DoESLiverpool/circular_knitic/Arduino/VarispeedStepperCircuit_bb.png

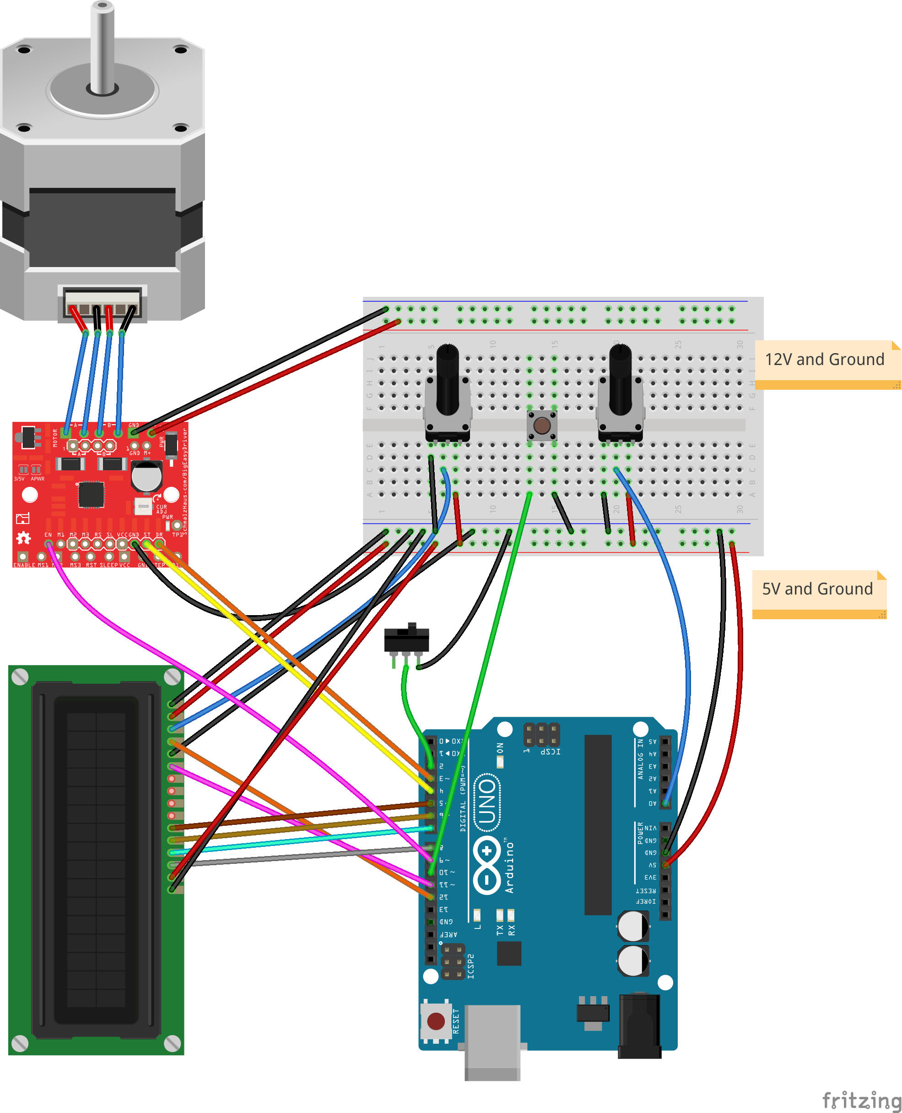
Arduino/VarispeedStepperCircuit_bb.png
