DoESLiverpool/circular_knitic/(list of files, drawings)

Other design files:
Arduino/VarispeedStepperCircuit.fzz
