DoESLiverpool/circular_knitic/(threads)

Thread 1 (2017-02-05):

Reassemble the contents of the electronics box

jackie1050, 2017-02-05:
Some of the electronics came apart when we disassembled the Knitic. There were also some wires that looks as though they had slightly overheated (we have always had issues with the fan). huffeec has taken the electronics box and contents home with the aim of getting a understanding of the best configuration, and getting it all working again.

huffeec, 2017-02-05:
Plan is to replace wires and get it back to working as it was, hopefully by or at the next maker night.
If anyone's got more time and wants to look at #3 at the same time I'd happily pass the bits over..

ajlennon, 2017-02-05:
I'd quite fancy trying to help out with #3 guys...

jackie1050, 2017-02-05:
That would be great – perhaps see how huffeec has got on by Thurs?
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

huffeec, 2017-02-06:
That'd be great @ajlennon
I'm not likely to be in the workshop before Thursday now but can drop off the bits before then if you want to have a look.

It's based on this at the moment,[https://github.com/DoESLiverpool/circular_knitic/blob/master/Arduino/CKcircuitSchema_pcb.jpg]( https://github.com/DoESLiverpool/circular_knitic/blob/master/Arduino/CKcircuitSchema_pcb.jpg) with an old PC PSU.

The motor is a [NEMA 23](http://www.active-robots.com/3330-0-57sth56-nema-23-bipolar-precision-gearless-stepper)

amcewen, 2017-02-17:
I've done some work on this, and completely rewritten the code for it.  The electronics are now next to the Knitic, and mostly wired up - it's missing the switch and the fan, but if you give it the 5V and 12V supplies then it'll run, and there's a new multi-turn potentiometer to allow finer-grained control.

The new code keeps track of how many steps it has triggered in `gStepCount` and prints out its RPM every five minutes to the serial port.  I think the calculated RPM might be double the RPM it's actually achieved, but haven't checked properly.  (Which is probably because the code thinks the Big Easy Driver is in 8-microstep mode, but it defaults to 16-microstep mode.  We can check that and update kStepsPerRevolution accordingly).

I've moved the circuit documentation to Fritzing.  It could do with the schematic tidying up (I've focused on the breadboard view so far) and the schematic and breadboard view exporting to images stored in the repo (to save anyone building one from installing Fritzing just to see how things are wired)

huffeec, 2017-03-11:
I've updated the code and circuit to include an LCD screen and controls for the row counter #3
This commit also has changes to the box of electronics svg to make space for the screen. The code is just 'Hello, Knitic' , and needs a line to convert between motor rotations and rows. (Anyone know what the gear ratio is?) dc1577902f17f0af19d053fcbce11e4b85cfec19

After maker day today I'm looking for a replacement 16x2 screen....

So, I've put the electronics box together without a screen and fixed the motor back. With progress on #5 the Knitic is now almost functional again. It needs the switch between pin2 and gnd, and the big easy board needs trimming.

huffeec, 2017-06-17:
The box was reassembled (without the screen) for Maker Faire.
It doesn't need any work, except if there is anything relating to #7 to be working for Make Fest.

paulgeering, 2017-06-18:
While swapping the PSU on Saturday (#7) I deactivated the arduino. (#13) This will be remedied Tomorrow.

paulgeering, 2017-06-19:
The electronics are now ready for Makefest Liverpool 2017. This will be the same setup as Newcastle (I.e. not using the screen and row counter)
#7 PSU tested and working
#13 Arduino replaced and tested.

Thread 2 (2017-02-05):

Replace the cracked upper surface of big gear

jackie1050, 2017-02-05:
The upper surface has been cracked since the Knitic was first assembled. 

jackie1050, 2017-02-05:
We cut another piece but it cracked when we tried to fit the 3D-printed "mountain" (cam). This appears to be due to the sharp corners and tight fit of the two pieces. We considered using MDF instead of acrylic, but decided this might be difficult to clean. We also considered rounding off the corners, but didn't do this as we had already printed off a new mountain using the existing file. It would be worth looking into this again if there are any future problems.

Kate bought a new piece of 5mm acrylic, and we cut a new upper surface using the existing .ai file (as we remembered there being scale problems with the svg). She filed down the mountain so that it fit better.

jackie1050, 2017-02-05:
Appears OK now

Closed 2017-02-05.

Thread 3 (2017-02-05):

Add a row counter

jackie1050, 2017-02-05:
Having a row counter would make it easier to replicate successful hats

huffeec, 2017-02-05:
The easiest way would be to count the rotations of the motor, but it does slip now and again. How accurate does it need to be?

Otherwise a little magnet on the big cog? I think there was a spare(?) Hall Effect sensor in the workshop, that might be enough. It'd also need a screen and possibly a button or two.

For persistence we would need a second switch to separate control of power and operation. This would also stop the lag we have at the moment waiting for the Arduino to power.

amcewen, 2017-02-17:
The new code (as mentioned in #1) tracks the number of steps made in a variable called `gStepCount`, so it would "just" need some sort of display adding to show that, and maybe a reset display to 0 button?

Thread 4 (2017-02-05):

Investigate replacement yarn tensioner

jackie1050, 2017-02-05:
We have had a lot of problems with this, and there is a new version on the main thread - Mar has recommended updating

Thread 5 (2017-02-05):

Reassemble Knitic

jackie1050, 2017-02-05:
On completion of #1

jackie1050, 2017-02-05:
... and make sure it's working well

huffeec, 2017-02-05:
This can happen independently of #1 the motor and box of electronics bolt onto the base.

It would be worth gluing the bottom and side pieces of the [box of electronics]( https://github.com/DoESLiverpool/circular_knitic/blob/master/2D_laser_cut/AI/box_of_electronics_5mm.ai ) together to make it easier to maintain.

A better solution to fix the power supply to the leg would be helpful too.

huffeec, 2017-02-24:
Made a lot of progress with @pounac on reassembling. Just needs the bearings refitting to the big cog, and the joining pieces on the 3d printed quadrants. Then everything could use checking for tightness.
I've glued the bottom of the electronics box together to make it easier to take apart in the future. For now just the switch and fan from #1 is enough to get this working again.

amcewen, 2017-06-10:
Given it has now been disassembled again, I'm going to use this to mark the reassembly for MakeFest.  This is dependent on issues #8 and #9 (at least).

huffeec, 2017-06-17:
The lower circle piece has been sanded to fit the bearing (from #8 which has been reassembled.)
and the inner ring and needles are in place.
Remaining are steps 11 - 14 in the [Circular Knitic instructable](https://www.instructables.com/id/Circular-Knitic/#step11)

Thread 6 (2017-02-05):

Reprint "mountain" cam, as wear could be causing problems

jackie1050, 2017-02-05:

jackie1050, 2017-02-05:
Once we disassembled the Knitic, we found that wear was less than we had been expecting. We took the opportunity to replace the mountain anyway.

Closed 2017-02-05.

Thread 7 (2017-03-11):

Replace PSU

huffeec, 2017-03-11:
We have a neater RS power supply that can replace the old computer unit.
It needs wiring and an enclosure that can be fixed under the box of electronics.
(Or the whole box of electronics redesigning?)

amcewen, 2017-06-10:
We've decided against the RS power supply now, haven't we?  Wasn't @paulgeering proposing switching to a beefy 12V wall-wart, so the barrel-jack plugs into the Arduino and we take the stepper feed from the Vin pin of the Arduino?

If so, how much current do we think the wall-wart needs to provide?

paulgeering, 2017-06-15:
Well, in the run up to Newcastle, I got a 12v 5A (60W) power supply for it and hooked it all up.
It was felt, by some experienced knitic users, that there was a noticeable drop in performance when using the new power supply, so we went back to using the PC power supply.

Shame the knitic is in pieces, otherwise we could run it and measure the current draw at 12v.

I guess we could put an artificial load on the stepper, and see what it maxes out at.
I'm around this evening, and happy to give that a go.

@amcewen do you have specs of the motor driver board max current draw, or is it the case that there is a recommended max, but the little board will try and keep up regarless of whether it is melting itself in the process?

amcewen, 2017-06-18:
@paulgeering It's a [Big Easy Driver board](http://www.schmalzhaus.com/BigEasyDriver/) which (according to that link) will handle around 2A per phase.  We could always try it on the bench power supply and look at how much current it draws in operation (with some wool in it), and then get something specced a healthy margin over that...

paulgeering, 2017-06-18:
On Saturday we measured the current draw at under 2 amps, we then did an A-B comparison between the PC power supply and the maplin one I mentioned.

They performed identically.

I've wired the knitic up so it will use the new power supply.

(The knitic is awaiting a replacement Arduino. I blew the current one up, as is my custom in the lead up to Maker fair/fest's.

There is a separate git hub issue for that, which will be resolved on Monday morning)

paulgeering, 2017-06-19:
New arduino in place. #13 Closed. All electronics working as expected.

Closed 2017-06-19.

Thread 10 (2017-06-10):

Fix eccentricity in stepper motor cog

amcewen, 2017-06-10:
The cog on the stepper motor wobbles quite a bit, which isn't helping how smoothly it runs.

amcewen, 2017-06-10:
A new cog (which will be cut as part of #9) might fix things.  Otherwise maybe it's because the mounting boss is for an imperial shaft and the shaft is metric. (Am I remembering that correctly @huffeec?)

huffeec, 2017-06-17:
Yes, the [motor](http://www.active-robots.com/3330-0-57sth56-nema-23-bipolar-precision-gearless-stepper) is 1/4" the [shaft mount](http://www.active-robots.com/pololu-universal-aluminum-mounting-hub-6mm-shaft-pair-m3-holes) is 6mm
I think it's more how the cog is mounted.
Rob replaced the cog to fix this.

Closed 2017-06-17.

Thread 11 (2017-06-10):

Upper surface keeps breaking

amcewen, 2017-06-10:
The laser-cut upper surface piece keeps snapping across the narrow part where the cut-out for the "mountain" part fits.

We suspect that it's caused by the stresses being focused in the sharp corner of the cut-out.  Rounding off that corner might fix things, which will need modifications to both the laser-cut part and the 3d-printed "mountain"

Kate2000, 2017-06-12:
[upper_surface_5mm_385mm.zip](https://github.com/DoESLiverpool/circular_knitic/files/1069012/upper_surface_5mm_385mm.zip)

I think this is the right sized version of the upper disk (385mm not 305mm) but it needs the circles on those corners.

Kate2000, 2017-06-12:
I've added in the circles (5mm) to save time.
Can you check if its ok? If not please can you re-do?

[upper_surface_5mm_385mm_mod.zip](https://github.com/DoESLiverpool/circular_knitic/files/1069056/upper_surface_5mm_385mm_mod.zip)

jackie1050, 2017-06-12:
Great – I’ll cut it tomorrow evening (13 June) then, unless anyone objects before then

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

huffeec, 2017-06-17:
The new circles are slightly out of round. It's especially a problem with the lower circle.
@paulgeering and @Kate2000 traced the problem with Gerald slightly distorting cuts 45 degrees to the axis.
We've sanded the current cut to fit the bearing and that should work for MakeFest. So the Knitic can be reassembled but longer term would benefit from new cuts.

jackie1050, 2017-06-19:
I bought a new piece of acrylic to make new circles once Gerald is fixed. I've written Knitic on the plastic covering, and stored it by the big pieces of polycarbonate for the moment

DefProc, 2017-06-21:
Gerald should now be ready for cutting rounds https://github.com/DoESLiverpool/somebody-should/issues/517

Thread 9 (2017-06-10):

Cut new 5mm acrylic pieces

amcewen, 2017-06-10:
We need an assortment of the 5mm acrylic parts cutting:

 * [x] [Cogs](https://github.com/DoESLiverpool/circular_knitic/blob/master/2D_laser_cut/SVG/bottom_surface_motor_gears_6mm.svg)
 * [x] [Upper surface](https://github.com/DoESLiverpool/circular_knitic/blob/master/2D_laser_cut/SVG/upper_surface_5mm.svg)
* [x] [Large gear]

jackie1050, 2017-06-14:
Done

Closed 2017-06-14.

Thread 13 (2017-06-18):

Knitic Arduino is low on magic smoke - Replace Arduino

paulgeering, 2017-06-18:
So, in a rush to head home on Saturday, I kinda blew up the arduino (again) by connecting the power backwards.

I will bring a replacement Arduino in on Monday morning, and swap it with the blown one.
Sorry

paulgeering, 2017-06-19:
New arduino installed. Knitic electronics tested and working.

DefProc, 2017-06-19:
@paulgeering just a thought, but this might not be a problem with an official board, the reverse polarity protection diode should trip the power supply by shorting it, rather than blowing the regulator

Closed 2017-06-19.
