DoESLiverpool/circular_knitic/(commit log)

2017-02-10 Naive implementation of a varying speed stepper driver
2017-02-14 Interrupt-driven variable stepper (running at 12rpm)
2017-02-16 Now disables the stepper driver when it's stopped.
2017-02-17 Add wiring diagram and new interrupt-driven code. Part of issue #1
    [VarispeedStepperCircuit.fzz]
2017-02-17 Moved circuit diagram into Fritzing. Part of #1
2017-02-17 Add speed control potentiometer to BOM. Part of #1
    [bill_of_materials.csv]
2017-03-10 Added LCD screen for row counter
    [VarispeedStepperCircuit.fzz]
2017-03-13 Fixed circuit
    [VarispeedStepperCircuit.fzz]
2017-03-13 Fixed circuit, added LED power
2017-03-24 Update box of electronics - Add reset button
